balta-dev/skytracker/docs/images/bias.png

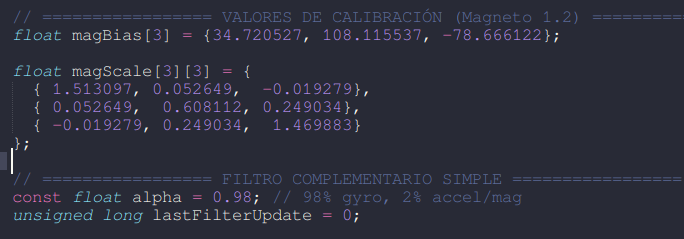
docs/images/bias.png
