balta-dev/skytracker/docs/images/magneto.png

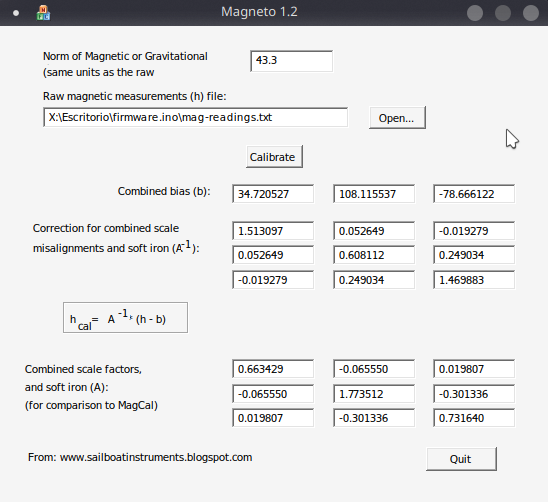
docs/images/magneto.png
