balta-dev/skytracker/esp32/CAD/laser_mount.stl

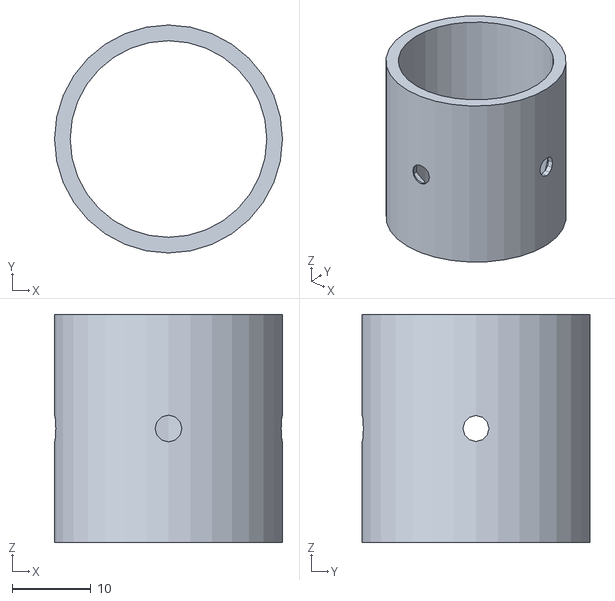
[picture p6: CAD file, 2025-11-06]
esp32/CAD/laser_mount.stl
29.0 x 29.0 x 29.0
