balta-dev/skytracker/esp32/CAD/DEC_mount.stl

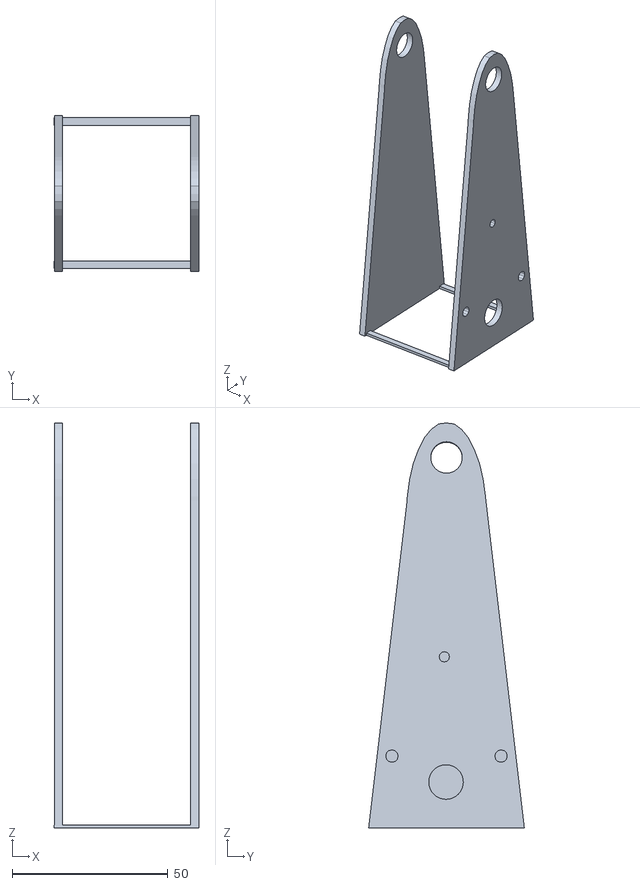
[picture p7: CAD file, 2025-11-06]
esp32/CAD/DEC_mount.stl
46.4 x 50.0 x 130.0
