balta-dev/skytracker/esp32/CAD/tripod_mount.stl

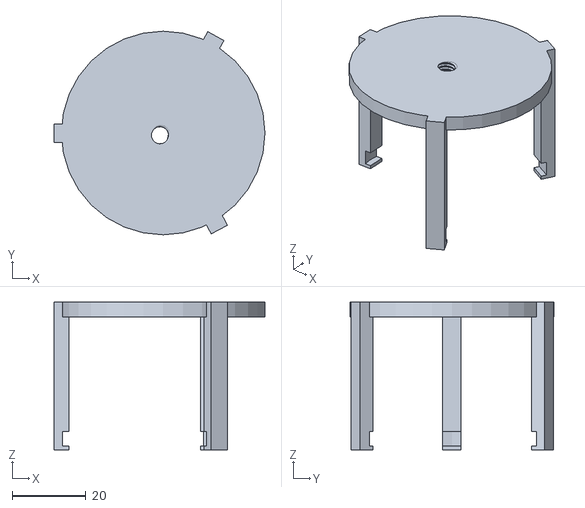
[picture p8: CAD file, 2025-11-06]
esp32/CAD/tripod_mount.stl
57.1 x 55.1 x 40.0
