balta-dev/skytracker/esp32/CAD/base.stl

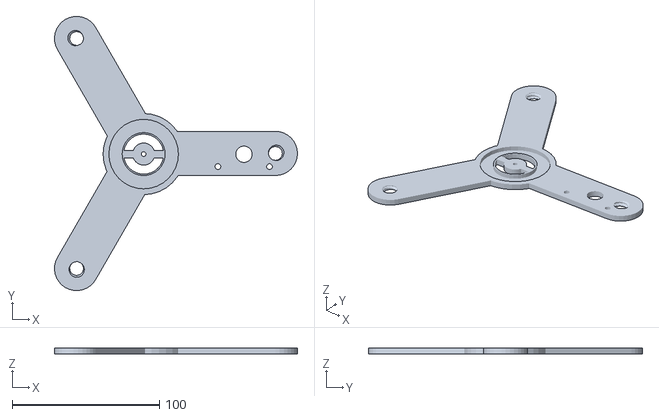
[picture p9: CAD file, 2025-11-06]
esp32/CAD/base.stl
165.0 x 186.1 x 4.00
