balta-dev/skytracker/esp32/CAD/base_gear_small.stl

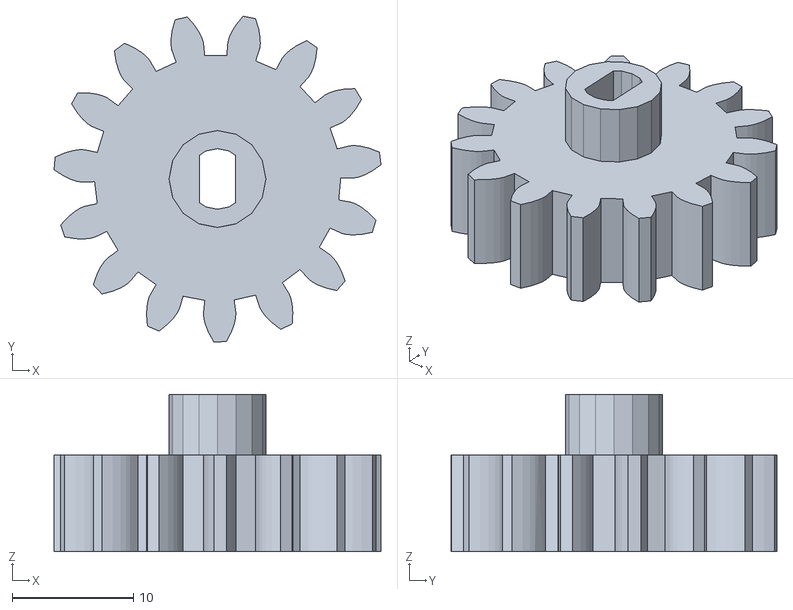
[picture p10: CAD file, 2025-11-06]
esp32/CAD/base_gear_small.stl
27.0 x 26.9 x 13.0
