balta-dev/skytracker/esp32/CAD/base_gear_big.stl

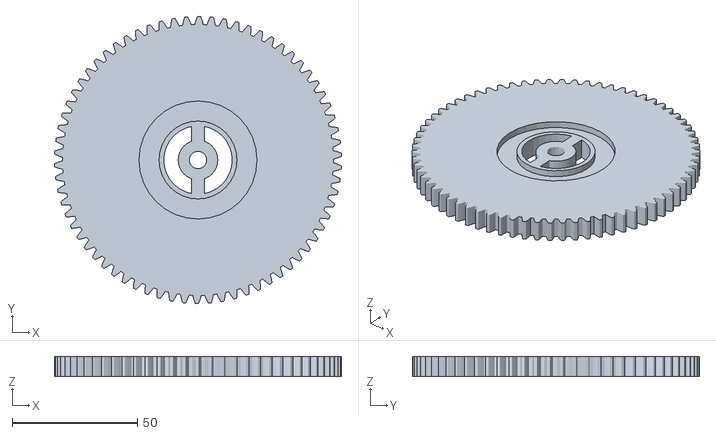
[picture p11: CAD file, 2025-11-06]
esp32/CAD/base_gear_big.stl
114.6 x 114.6 x 8.00
