balta-dev/skytracker/esp32/CAD/first_gear_DEC.stl

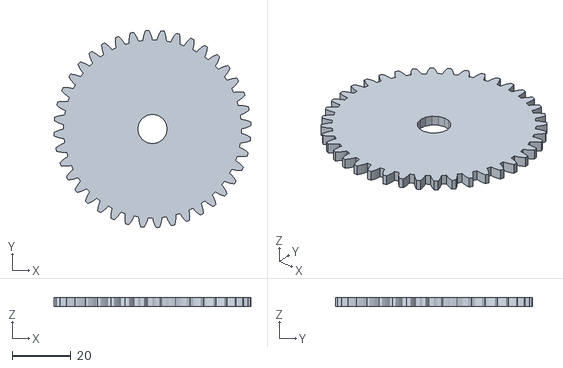
[picture p12: CAD file, 2025-11-06]
esp32/CAD/first_gear_DEC.stl
66.8 x 66.8 x 3.00
