balta-dev/skytracker/esp32/CAD/gyro_mount.stl

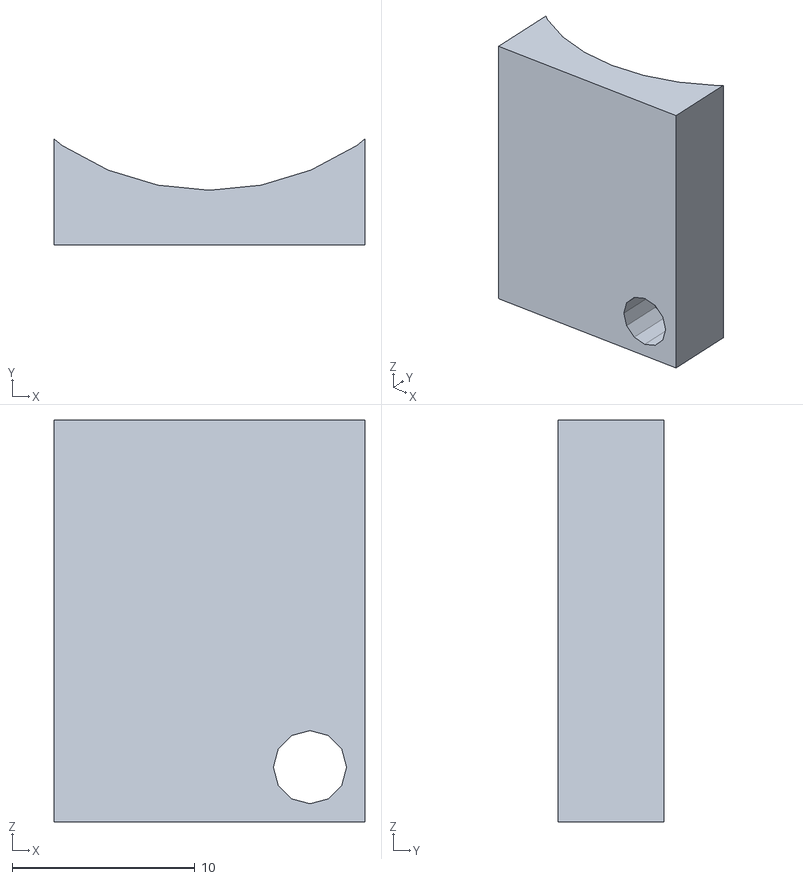
[picture p13: CAD file, 2025-11-06]
esp32/CAD/gyro_mount.stl
17.0 x 5.81 x 22.0
