balta-dev/skytracker/esp32/CAD/small_gear_DEC.stl

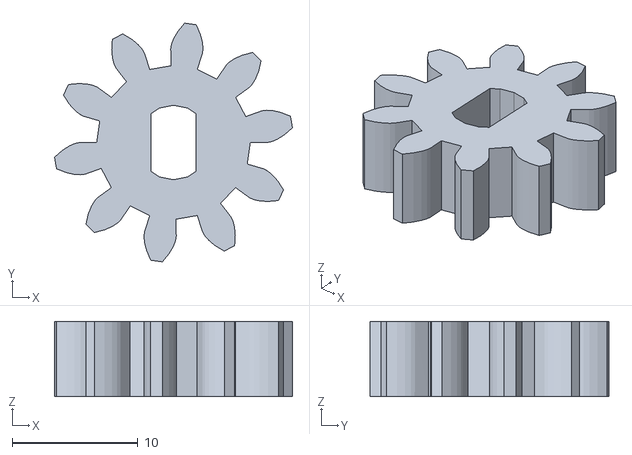
[picture p15: CAD file, 2025-11-06]
esp32/CAD/small_gear_DEC.stl
19.0 x 19.0 x 6.00
