balta-dev/skytracker/esp32/CAD/base_screw.stl

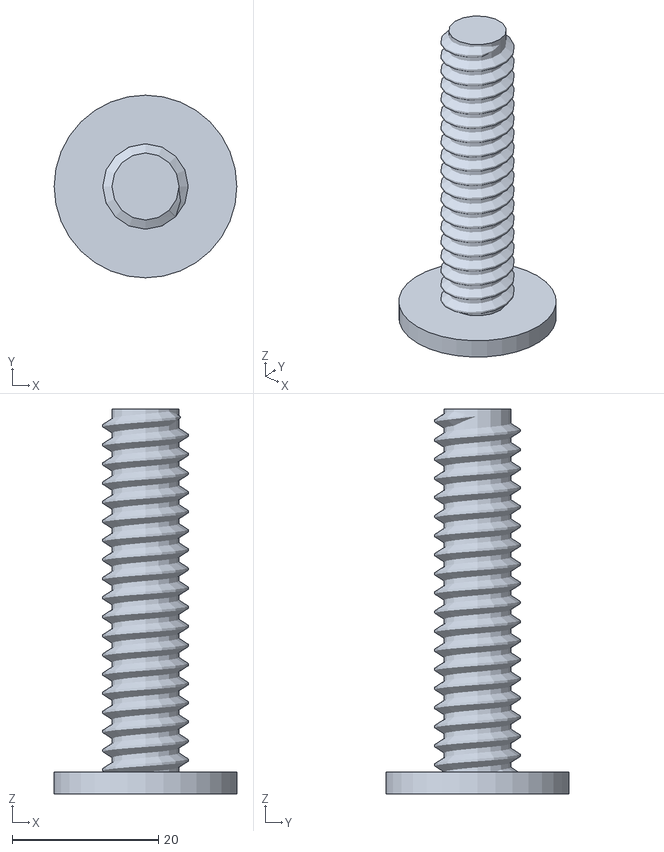
[picture p16: CAD file, 2025-11-06]
esp32/CAD/base_screw.stl
25.0 x 25.0 x 52.7
