balta-dev/skytracker/(commit log)

2025-10-17 Primer commit: subida inicial de archivos
2025-10-17 Crear README.md para proyecto SkyTracker
    Agregado un README detallado para el proyecto SkyTracker incluyendo instalación, uso, y controles.
2025-10-17 Actualizar instrucción de clonar repositorio en "README.md"
2025-10-17 perf(renderer): optimiza renderizado de texto con caché y batch
2025-10-17 Agregar escritura en serial para yaw/pitch
2025-10-17 Fix nombre de directorio en instrucciones de clonado
2025-10-18 Actualizar README con simulador y vistas esquemáticas
    Se agregaron secciones de simulador y vista esquemática con imágenes.
2025-10-18 Incluir ejemplo de control servo en README
    Se agregó código de ejemplo para control de servo usando potenciómetros.
2025-10-18 Solucionar problema de drifteo e impresición de cámara
2025-10-18 Agregar vector reportado por ESP32
2025-10-18 Cambiar tamaño de los planetas
2025-10-18 Agregar delay de vector verde para simulación
2025-10-19 Cambiar celestial_data para guardar en un json. Agregar 'skyfield' a la lista de requerimientos. Agregar 'de421.bsp'.
2025-10-19 Actualizar el README con la nota de la calculadora de efemérides
    Se agregó una nota sobre ejecutar ephemeris_calculator.py regularmente y se eliminaron notas obsoletas sobre las dependencias.
2025-10-19 Mejora visibilidad de estrellas. Agregado 'Sol' para recálculos. Agregado shaders para bloom (wip).
2025-10-19 Solucionar yaw=180 al norte. Solucionar problema de latitud incorrecta.
2025-10-19 Agregar versión de consola. Arreglar problema de Bloom.
2025-10-20 Agregar profiler para controlar cuellos de botella. Optimización general (y sobre todo el domo)
2025-10-20 Cambiar visibilidad de estrellas, mejorar configuración de bloom
2025-10-21 Optimización de gran calibre
2025-10-21 Arreglar posicionamiento de la luna
2025-10-21 Agregar nuevo requerimiento para carga de texturas
2025-10-21 Solucionar ya no escribe 'T' al arrancar el buscador. Agregado label encima del crosshair para facilitar visibilidad
2025-10-23 Reducir deadzone. No permitir activar/desactivar bloom si el cuadro de búsqueda está abierto
2025-10-23 Solucionar problema de cámara inicial. Reducir tamaño de Jupiter. Ajustar compensación de rotación de mouse.
2025-10-25 Agregar funcionalidad como server TCP a la versión de consola
2025-10-25 refactor: reorganización de estructura del proyecto
2025-10-25 commit inicial de aplicación de móvil
2025-10-25 Revisar README.md para mayor claridad y actualizaciones
    Se actualizaron el título y las descripciones del proyecto en el archivo README.md. Se ajustaron las rutas y se añadieron detalles sobre la interfaz de usuario y la funcionalidad.
2025-10-28 Agregar funcionalidad ESP32
2025-10-29 Solucionar problemas con inconsistencia de datos
2025-10-29 Mejorar visual (desaparece info de caché después de unos segundos)
2025-10-29 Mejorar visual (info caché, conectando, animación para seleccionar modo). Agregar handler para KeyboardInterrupt
2025-10-29 Actualizar HttpClient para ser seguro. Incluir cadena de certificados de ssd.jpl.nasa.gov
2025-10-29 Quitar angulos de feedback cuando deja de rastrear
2025-10-30 Agregar esquema de funcionamiento general
2025-11-03 Cambiar portada de README
2025-11-06 Agregar objetos faltantes. Ejecutar actualización al abrir
    [DEC_mount.stl, base.stl, base_gear_big.stl, base_gear_small.stl, base_screw.stl, first_gear_DEC.stl, gyro_mount.stl, laser_mount.stl]
2025-11-12 Actualizar el archivo README con los detalles del proyecto y la guía de uso.
    Se actualizó la descripción del proyecto, se añadieron instrucciones de uso y se mejoró el formato.
2025-11-14 Agregar código fuente para ESP32. Agregar README.md instructivo.
2026-03-20 Cambiar fuente de imagen en README
    Actualizado la fuente de imagen en README
